CarbonSpark/CS_XCub_ThrottleQuad/Arduino Code/readme

This folder contains the code file I used for the Arduino Teensy 4.1 that is driving the prototype unit.
