CarbonSpark/CS_XCub_ThrottleQuad/Fuel Selector/readme

This folder contains all of the STL's for the Fuel Selector Switch.
