CarbonSpark/CS_XCub_ThrottleQuad/Levers/readme

This folder contains all of the STL's for the Throttle and Prop Levers.
