CarbonSpark/CS_XCub_ThrottleQuad/Flap Lever/readme

This folder contains all of the STL's for the Flap Lever Arm.
