CarbonSpark/CS_XCub_ThrottleQuad/Covers/readme

This folder contains all of the cover panel STL's for the Throttle.
