CarbonSpark/CS_XCub_ThrottleQuad/Frames/readme

This folder contains all of the STL files to build the main framework for the throttle unit.
