CarbonSpark/CS_XCub_ThrottleQuad/Documents/Hardware List.xlsx

Component Type | Fastener Qty | Description | Notes | McMaster Carr Part Number
Frames
 | 37 | M3 x 0.5mm Heat Set Insert, brass, short | Primary fasteners for M3 screw embeded into parts. Used for cover panels and non load bearing parts. Sourced from Amazon
 | 32 | M4 x 0.7mm Heat Set Insert, brass, short | Primary fasteners for M4 screw embeded into parts. Used for load bearing and frame to fram connections. Sourced from Amazon
 | 2 | M3 x 0.5mm x 12mm Socket Head Screws | Attaches the Top Frame Bracket to both Flap Lever Side brackets. | 91290A117
 | 32 | M4 x 0.7mm x 12mm Socket Head Screws | Main Screws used for assembling the frames together. | 91290A148
 | 6 | M4 x 0.7mm x 8mm Socket Head Screws | For attaching the bottom of Throttle Frames to Center Frame | 91292A108
 | 6 | M4 x 0.7mm x 20mm Socket Head Screws | For attaching the top of Throttle Frames to Top Frame. | 91290A168
 | 6 | M4 0.7mm Lock Nuts | For the 20mm M4 Screws used on the top of the Throttle frames.
Cover Panels
 | 6 | M3 x 0.5mm x 5mm Button Head Screws | For attaching the top cover to the top frame. | 94500A263
 | 32 | M3 x 0.5mm x 6mm Button Head Screws | For attaching all remaining cover panels to frames. | 94500A221
Flap Lever
 | 1 | 3mm x 40mm Dowel Pin | Trigger Stop Pin. Prevents the push rod assembly from pushing the trigger out of the handle. | 93890A702
 | 1 | 3mm x 16mm Headless Clevis Pin w/E-clips | Axle for trigger. | 91595A117
 | 1 | 6mm x 30mm Headless Clevis Pin w/E-clips | Axle for detent pawl and spacers. Shaved the head of this pin to clearance the bolts holding the Detent Bracket to the Flap Frame | 93890A713
 | 2 | 13mm OD, 8mm Long, M6 Aluminum Spacer | These are the spacers for the detent pawl. One on each side of the pawl. Filing/milling required as the pawl needs to move with no resistance. | 94669A172
 | 2 | 8mm OD, 13mm long, M4 Aluminum Spacer | These are the spacers for the Detent Plate to Detent Bracket. | 94669A051
 | 2 | M4 x 0.7mm x 25mm screws | These screws attach the Detent Plate to the Detent Bracket.
 | 2 | M4 x 0.7mm x Lock Nuts | For the Detent Plate screws.
 | 2 | M4 x 0.7mm Washers | For the Detent Plate screws.
 | 1 | M6 x 1mm x 110mm Socket Head Screw | Attaches Flap Lever Arm through Flap Lever Axle and both Flap Side Frames. Can also use to adjust tension on the Flap Lever Arm | 91292A420
 | 1 | M6 x 1mm Lock Nut | For M6 110mm screw | 94205A153
 | 1 | M6 screw size Nylon Washer, Lubricant Filled | Located between Flap Lever Axle and Flap Support Frame 2, Lubricant Filled for smooth rolling action on the assembly. | 91545A450
 | 1 | 6201 Ball Bearing | Bearing used flap system to provide smooth rolling action. | 5972K313
 | 1 | 5mm OD aluminum rod | This is the push. Approx. 90mm long with the gentle bend. Must be custom fit to the assembly. Sourced from Amazon
 | 1 | 17mm Compression Spring | Push rod return spring. I used a 2.8 pound spring. Must be 17mm uncompressed. | 94125K523
 | 2 | M5 Oversized Washer | Retain 17mm spring to prevent binding, One on each end of the spring. | 91100A140
 | 1 | 5mm OD Push on Retaining Ring | For keeping the Washers and spring in place on the Trigger end of the Push rod | 92133A106
 | 2 | M4 x 0.7mm x 8mm Socket Head Screws | For mounting Detent Bracket to Flap Support Frame 1 | 91292A108
 | 1 | M4 x 0.7mm Nut (any type) | Epoxy this to the top of the Detent Pawl above the foot that push rod hits. This is used as a counter weight.
Flap Lever Switches
 | 2 | M3 x 0.5mm x 70mm Socket Head Screws | Attached the Flap Lever Switches through both Flap Support Frames and Flap Switch Cradle. | 91290A297
 | 2 | M3 x 0.5mm Lock Nuts | For the 70mm screws above.
Fuel Selector
 | 4 | M4 x 0.7mm x 20mm Socet Head Screw | Attaches the Cutoff Guard Mount Ring to Switch Cup | 91290A168
 | 4 | M4 Lock Nuts | For Cutoff Guard Mount Ring Screws
 | 2 | Precision M5 Shoulder Bolts, Ultra Low Profile | Ultra-Low-Profile Precision Shoulder Screw, 5 mm Shoulder Diameter, 10 mm Shoulder Length, M4 x 0.70 mm Thread. For Cutoff Guard | 90318A810
 | 2 | 11.5mm Long Compression Springs | For Cutoff Guard. Mounts under the guard, with the shoulder bolt through the spring. 2.8 pound springs. | 94125K521
 | 2 | M4 Heat Set Insert, brass, short | For mountin the shoulder bolts to the ring. Sourced from Amazon.
T&P Levers
 | 2 | Knurled M5 Knobs | These knobs are the axles for the Throttle and Prop Levers. Also used for tensioning the Levers. M5 x 0.8mm x 25mm long stud. | 61165K71
 | 5 | M5 Nylon Washers, Lubricant filled. | Use 1 between each Front Lever Plate (magnet side) and the Left/Right Throttle Frames. Remaining are used as spacers on the Knob, inside housing. | 91545A440
 | 2 | M5 x 0.8mm Nuts, Non Locking | Used on the Rear Lever Plate, Holds each assembly together. Loctite optional.
 | 8 | M2 x 0.4mm x8mm screws, Phillips Head | Use in conjuction with nuts and lock washer to asseble lever plates. Sourced from Amazon as part of a screw kit.
 | 8 | M2 x 0.4mm x8mm nuts | For 8mm screws
 | 8 | M2 x 0.4mm x8mm lock washers | For 8mm screws
 | 1 | 3/4" x 1/16" Aluminum Flat Bar | Sourced from local home improvement store. These are the Prop/Throttle Levers. Bend to desired shape. Drill 5.2mm hole in center for the Knobs
 | 2 | M3 x 0.5mm x 6mm Button Head Screws | For attaching the Prop and Throttle Knobs.
 | 4 | 1/8" x 1/4" Foam Weather Strip, cut to length | Used on the Top frame slots for the Throttle and Prop Levers. Adds resistance to the levers, keeps dust out of the slots. Sourced from Amazon
 | 2 | 1/8" x 1/8" x 1/2" Neodymium Magnets | These magnets are for the hall effect sensors. Poles are oriented at the small ends of the magnet, not the long face. | www.KJmagnetics.com
Electronics
 | 2 | Honeywell SS496A1 Hall Effect Sensors | Hall effect Sensors for the Throttle and Prop Sensors. Epoxied in the small notch on the inside of Left/Right Throttle Frames. | AlliedElectronics.com
 | 1 | C&K Rotart Switch A12405RNZB | Fuel Selector Switch. 4 position, 90 degree indexing. | Mouser.com
 | 4 | E-Switch LS0851505F250C1A Limit Switches | Flap position switch. Roller faced, lever action limit switch. | Mouser.com
 | 3 | C&K DF62J12S215QA Rocker Switch | Basic SPDT Rocker Switch. Closest resemblance to the switches in the actual Xcub. Water Rudder, Gear, Parking Brake switches | Mouser.com
 | 1 | Arduino Teensy 4.1 | The brain of the unit. Sourced from Amazon but available at other locations. You can use any controller you want, I just used this one.
 |  | 24 Gauge Wire (any color) | I used stranded for everything but the common ground which is solid wire.
 |  | Heatshrink Tubing (various sizes)
 |  | Dupont style Male/Female Pins and Connectors | For terminating wires and hooking up to the Arduino
Desk Mount
 | 1 | J-Pein Universal Joystick Mount | Sourced from Amazon, this is an inexpensive mount for a joystick. Modified by cutting the main bar to length for the throttle.
 |  |  | Additional Comments
 |  |  | The hardware list above contains everything I have used to build the prototype unit. The list is rather extensive. There is a chance that I may have missed
 |  |  | something. If that is the case, DM me on the BLL discord (CarbonSpark) and I will add it to the list.
 |  |  | I used McMaster Carr as a harware provider. They are a US based company and if they don’t have it, it doesn't exist. If the part number from McMaster isn't
 |  |  | listed next to the line item, it is because I used a generic fastener I had on hand (like the M4/M3 lock nuts). You can use a substitute.
