CarbonSpark/CS_XCub_ThrottleQuad/Covers/Back Cover.stl

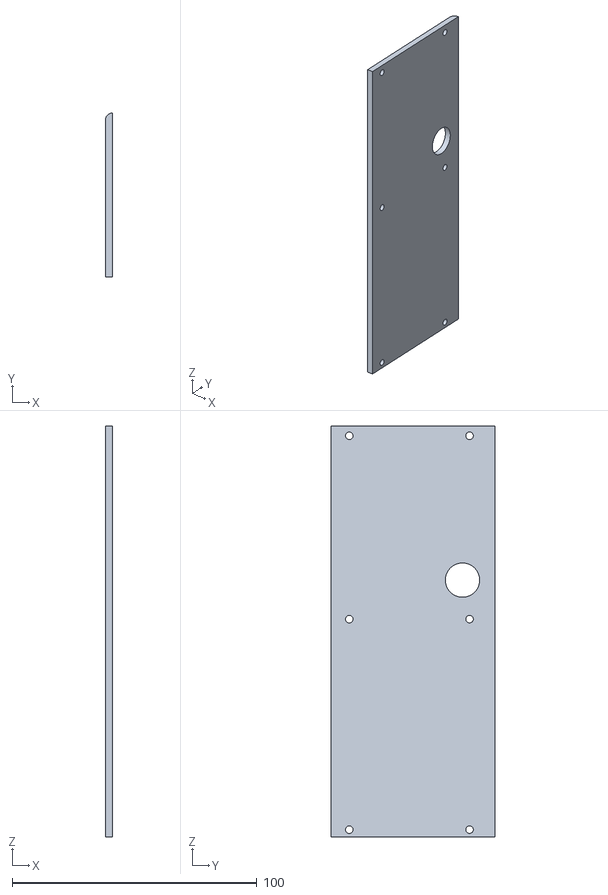
[picture p1: CAD file, 2021-11-14]
Covers/Back Cover.stl
3.00 x 67.1 x 168.0
