CarbonSpark/CS_XCub_ThrottleQuad/Flap Lever/Upper Push Rod Guide.stl

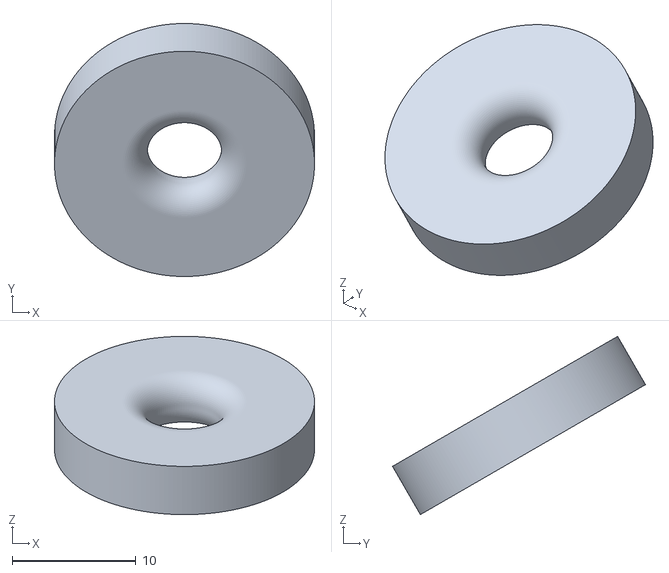
[picture p2: CAD file, 2021-11-14]
Flap Lever/Upper Push Rod Guide.stl
21.0 x 20.4 x 14.4
