CarbonSpark/CS_XCub_ThrottleQuad/Frames/Top Frame.stl

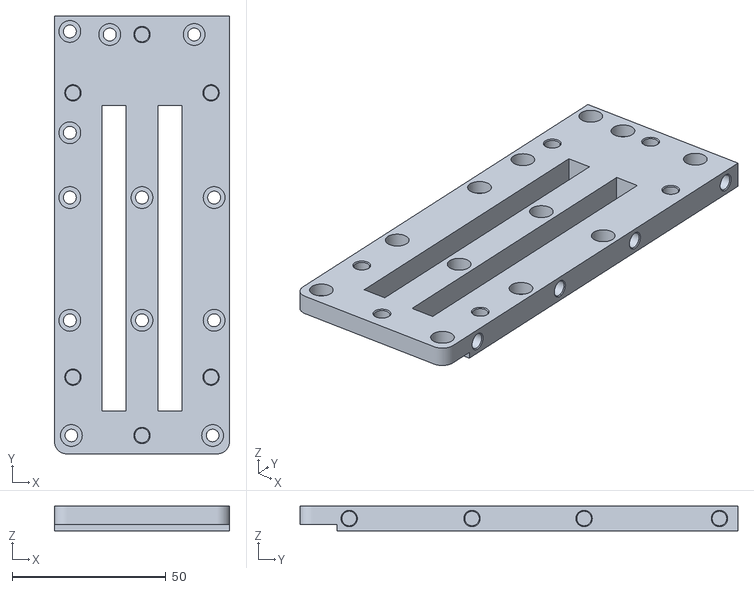
[picture p3: CAD file, 2021-11-14]
Frames/Top Frame.stl
57.0 x 142.6 x 8.00
