CarbonSpark/CS_XCub_ThrottleQuad/Fuel Selector/Fuel Selector Cup_V2.stl

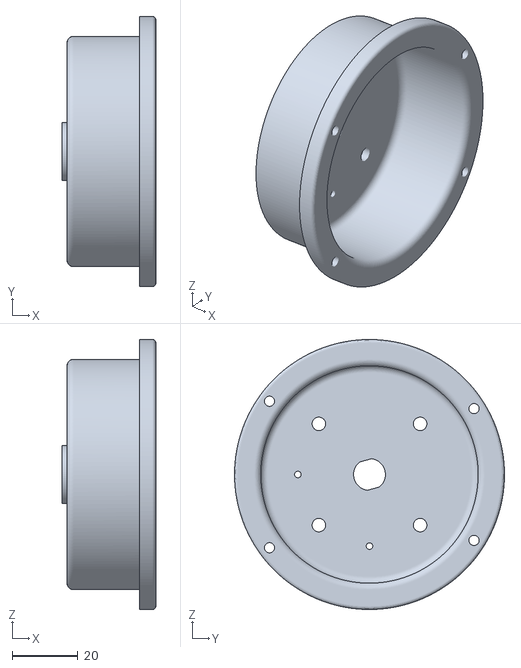
[picture p4: CAD file, 2021-11-14]
Fuel Selector/Fuel Selector Cup_V2.stl
28.5 x 82.0 x 82.0
