CarbonSpark/CS_XCub_ThrottleQuad/Levers/Lever Plate Front.stl

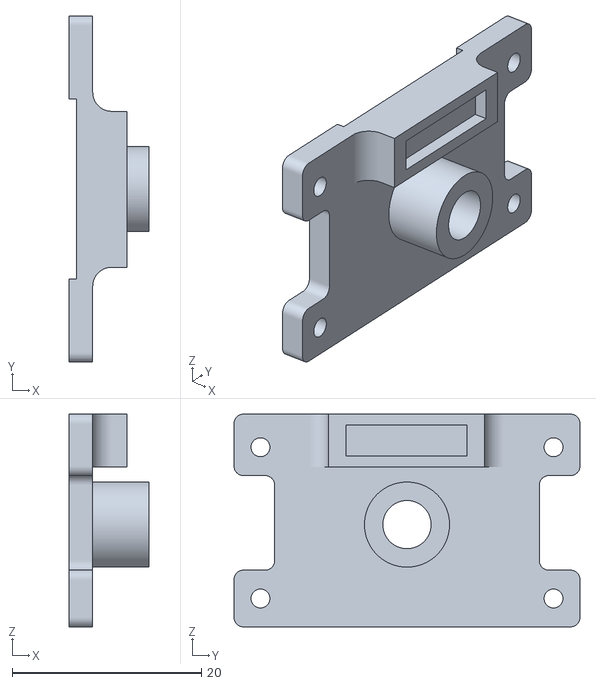
[picture p5: CAD file, 2021-11-14]
Levers/Lever Plate Front.stl
8.44 x 36.6 x 22.5
