CarbonSpark/CS_XCub_ThrottleQuad/Covers/Upper Front Cover.stl

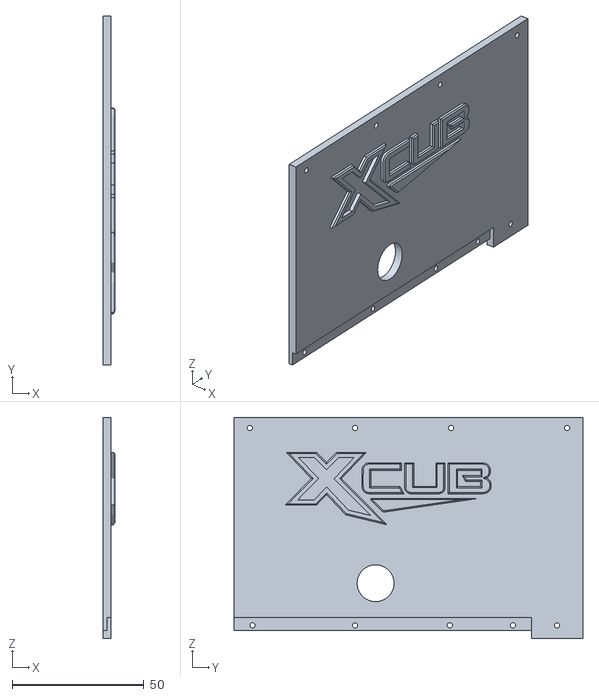
[picture p6: CAD file, 2021-11-14]
Covers/Upper Front Cover.stl
4.50 x 132.6 x 84.0
