CarbonSpark/CS_XCub_ThrottleQuad/Flap Lever/Flap Detent.stl

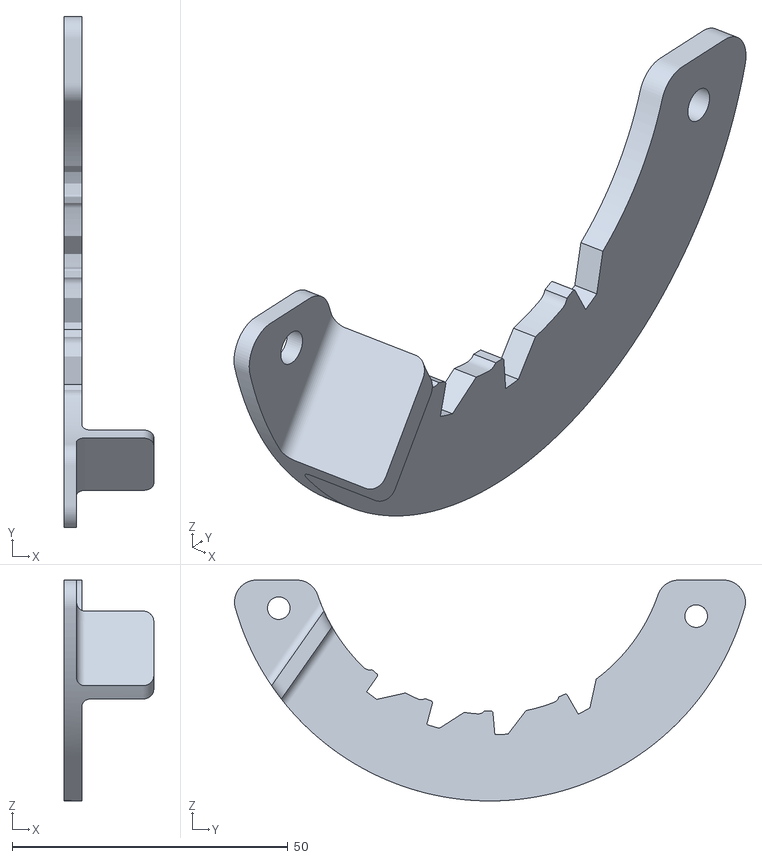
[picture p7: CAD file, 2021-11-14]
Flap Lever/Flap Detent.stl
16.3 x 92.7 x 40.1
