CarbonSpark/CS_XCub_ThrottleQuad/Frames/Arduino Bracket.stl

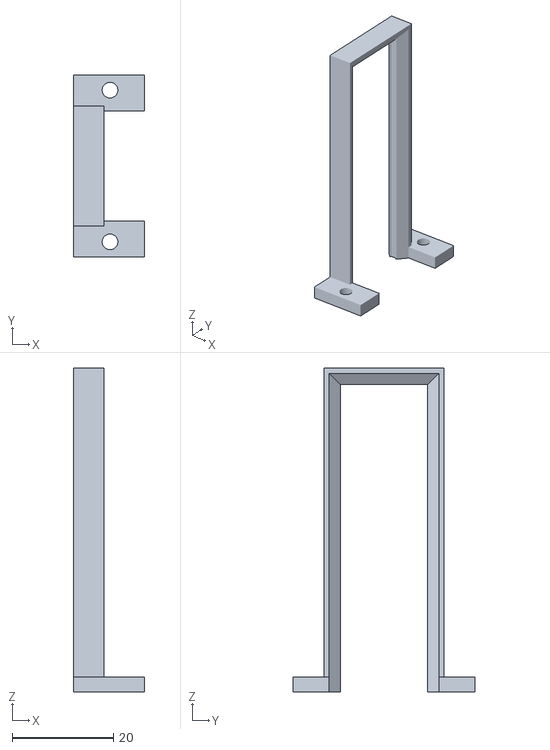
[picture p8: CAD file, 2021-11-14]
Frames/Arduino Bracket.stl
14.0 x 36.0 x 64.0
