CarbonSpark/CS_XCub_ThrottleQuad/Fuel Selector/Guard Mount Ring.stl

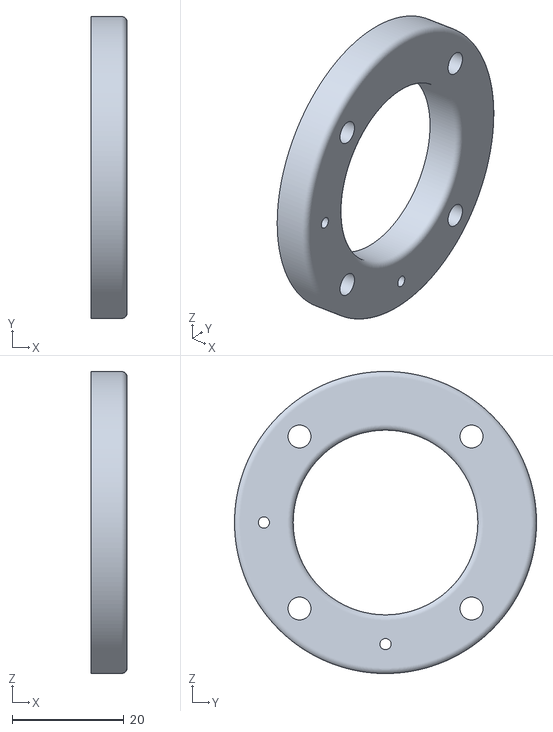
[picture p9: CAD file, 2021-11-14]
Fuel Selector/Guard Mount Ring.stl
6.50 x 54.0 x 54.0
