CarbonSpark/CS_XCub_ThrottleQuad/Levers/Throttle Knob.stl

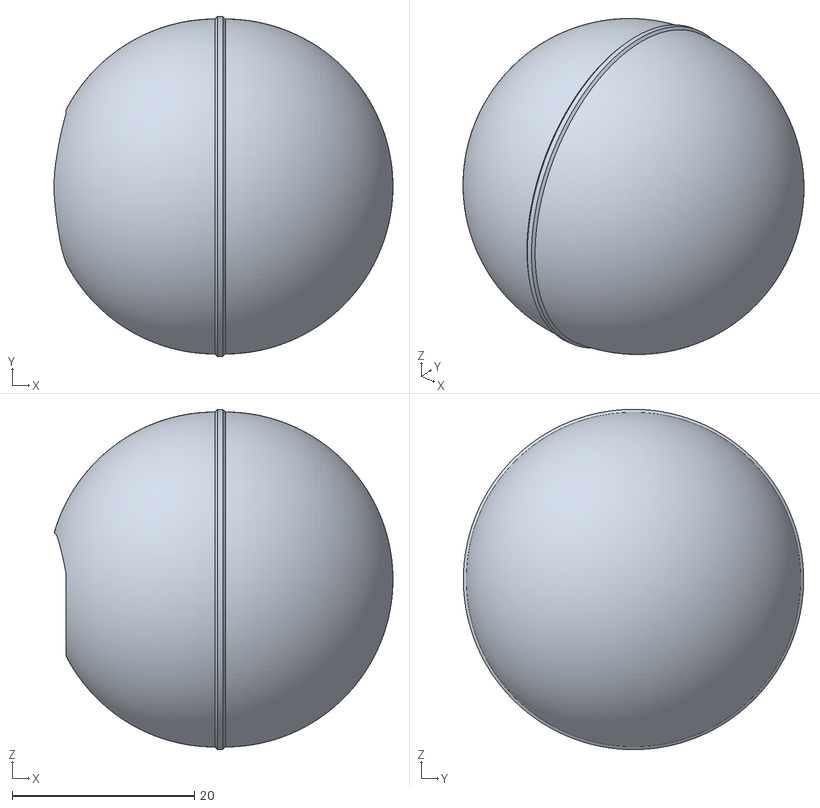
[picture p10: CAD file, 2021-11-14]
Levers/Throttle Knob.stl
37.2 x 37.4 x 37.4
