CarbonSpark/CS_XCub_ThrottleQuad/Covers/Short Side Cover.stl

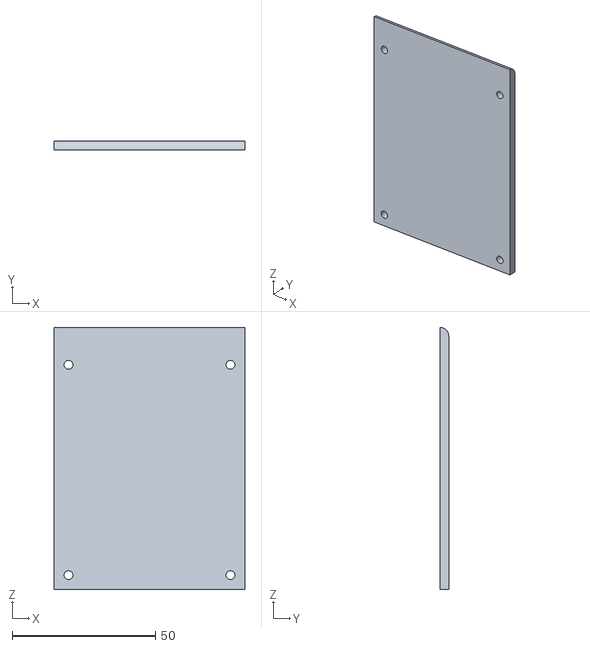
[picture p11: CAD file, 2021-11-14]
Covers/Short Side Cover.stl
66.5 x 3.00 x 91.4
