CarbonSpark/CS_XCub_ThrottleQuad/Flap Lever/Flap Bearing Cover.stl

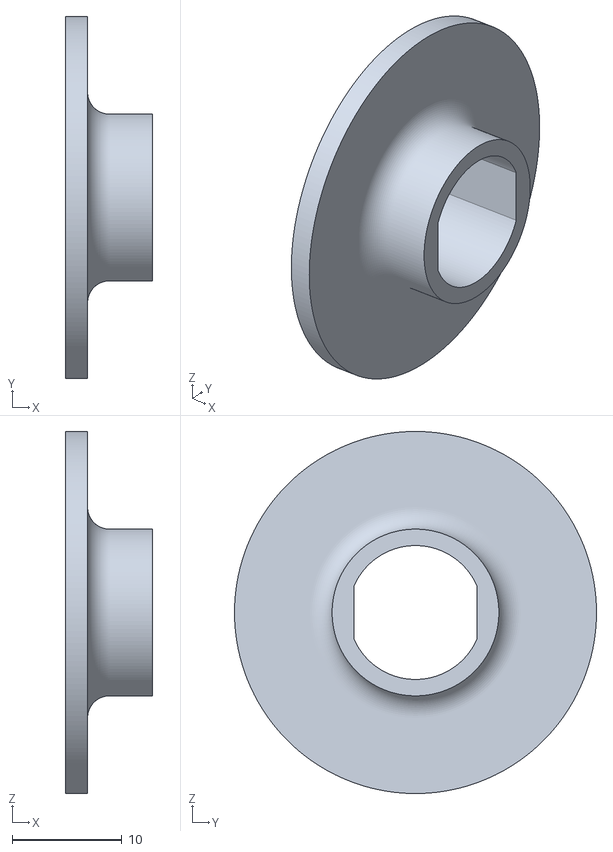
[picture p12: CAD file, 2021-11-14]
Flap Lever/Flap Bearing Cover.stl
7.90 x 33.0 x 33.0
