CarbonSpark/CS_XCub_ThrottleQuad/Frames/Center Support Throttle.stl

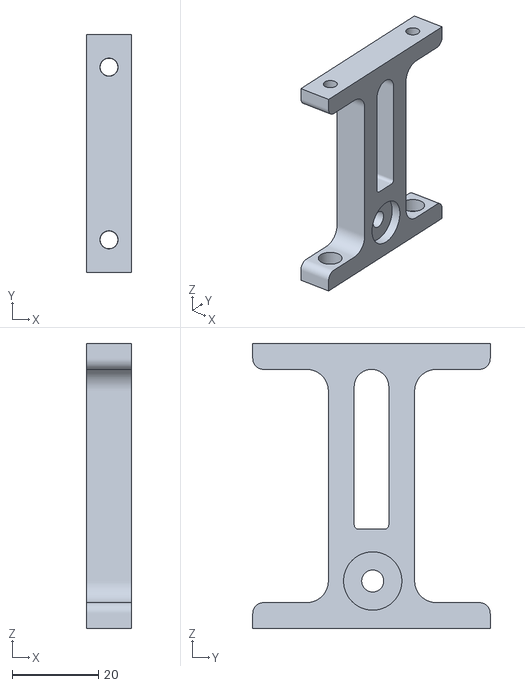
[picture p13: CAD file, 2021-11-14]
Frames/Center Support Throttle.stl
10.5 x 55.0 x 66.0
