CarbonSpark/CS_XCub_ThrottleQuad/Fuel Selector/Fuel KnobV2.stl

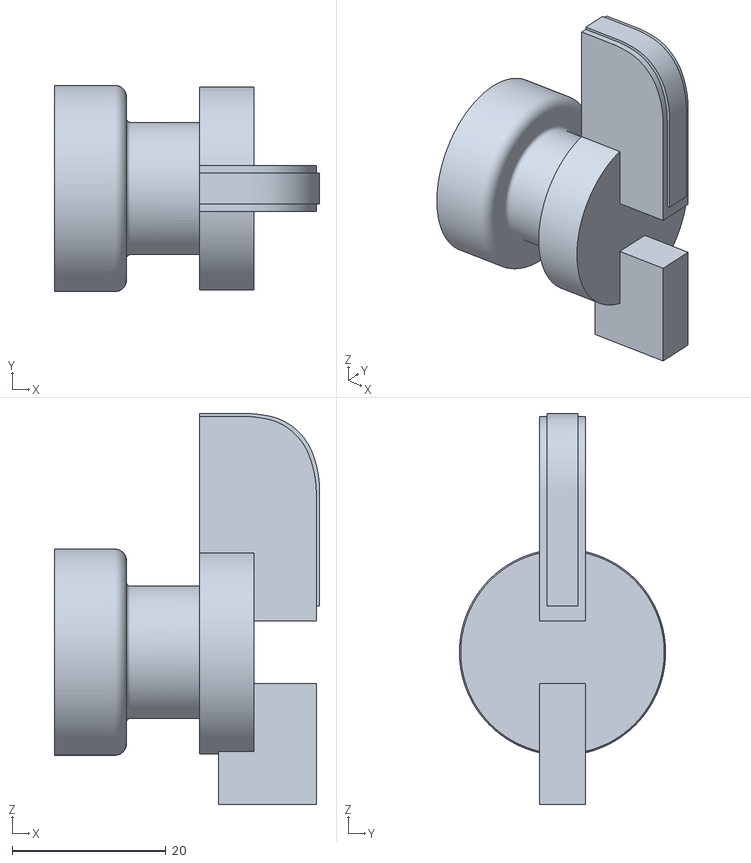
[picture p14: CAD file, 2021-11-14]
Fuel Selector/Fuel KnobV2.stl
34.5 x 26.8 x 50.9
