CarbonSpark/CS_XCub_ThrottleQuad/Levers/Lever Plate Back.stl

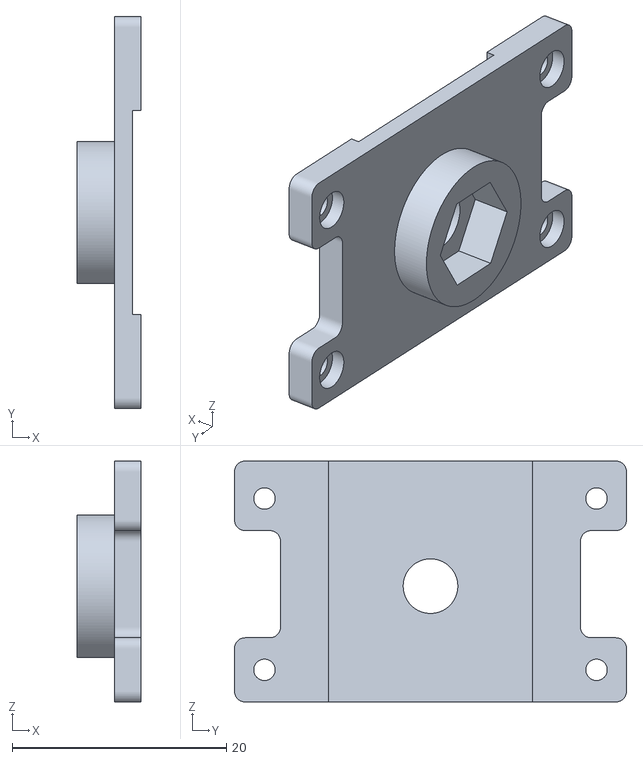
[picture p15: CAD file, 2021-11-14]
Levers/Lever Plate Back.stl
6.00 x 36.6 x 22.5
