CarbonSpark/CS_XCub_ThrottleQuad/Covers/Top Cover.stl

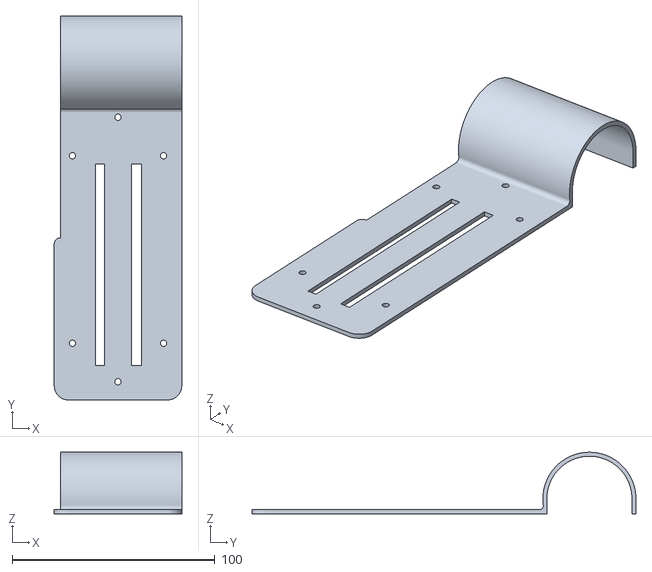
[picture p16: CAD file, 2021-11-14]
Covers/Top Cover.stl
63.0 x 189.6 x 30.4
