CarbonSpark/CS_XCub_ThrottleQuad/Flap Lever/Spring Plate.stl

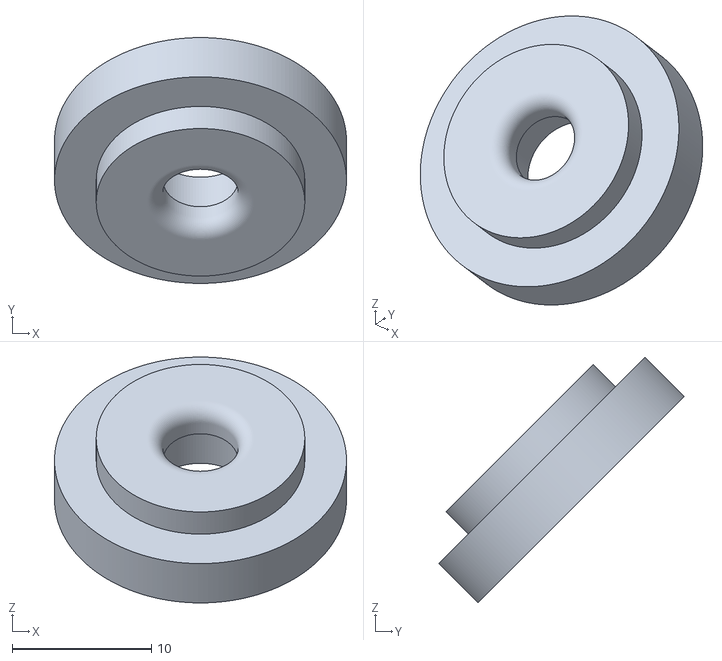
[picture p17: CAD file, 2021-11-14]
Flap Lever/Spring Plate.stl
21.0 x 17.7 x 17.7
