CarbonSpark/CS_XCub_ThrottleQuad/Frames/Flap Support Frame 1.stl

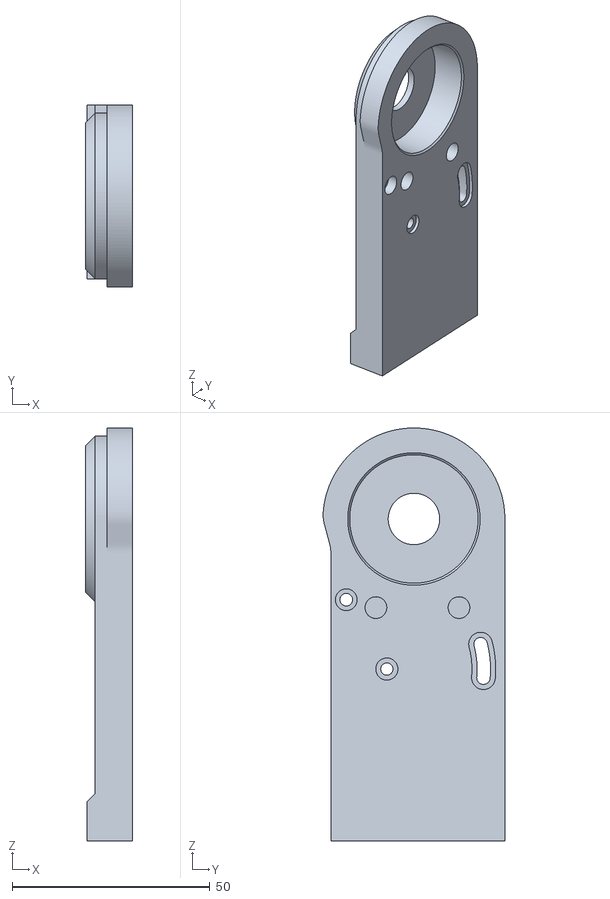
[picture p18: CAD file, 2021-11-14]
Frames/Flap Support Frame 1.stl
12.0 x 46.0 x 104.4
