CarbonSpark/CS_XCub_ThrottleQuad/Fuel Selector/Cutoff Guard.stl

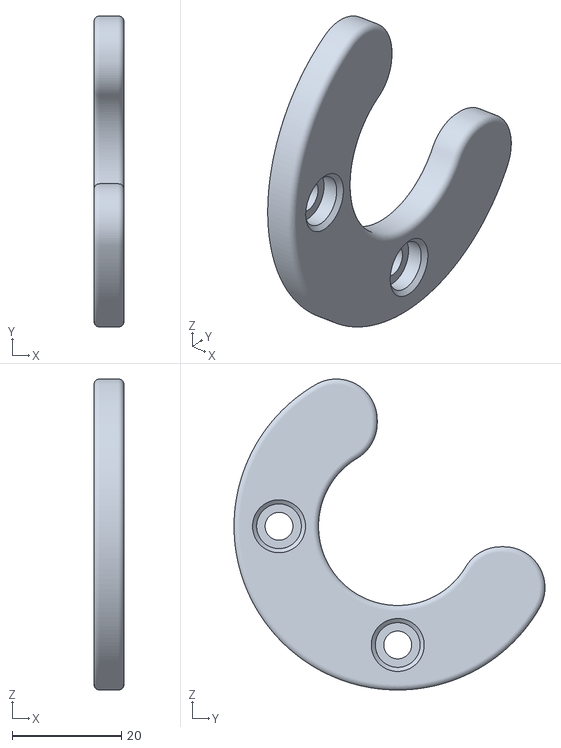
[picture p19: CAD file, 2021-11-14]
Fuel Selector/Cutoff Guard.stl
5.50 x 57.0 x 57.0
