CarbonSpark/CS_XCub_ThrottleQuad/Levers/Prop Knob.stl

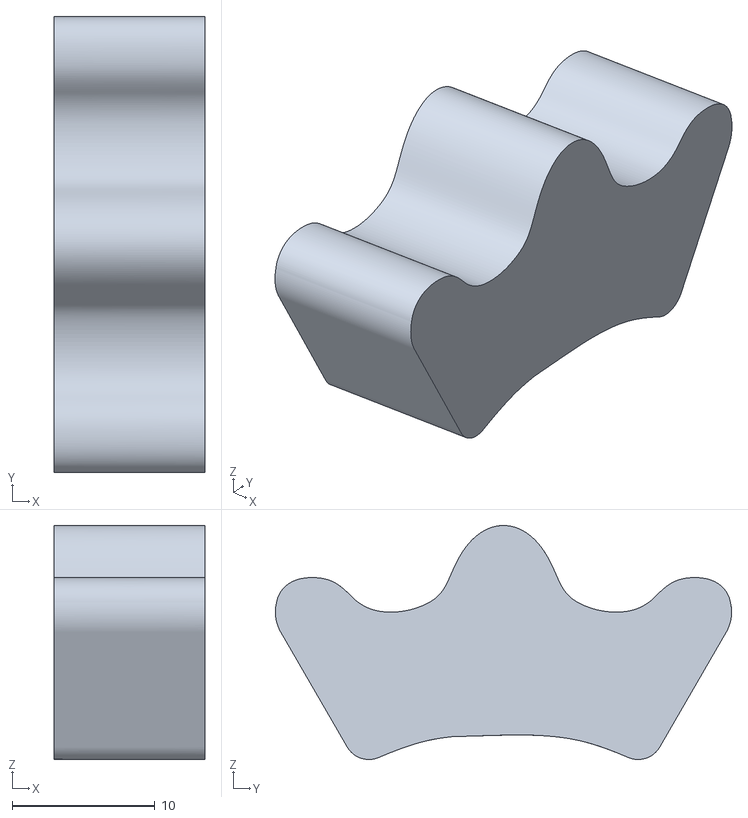
[picture p20: CAD file, 2021-11-14]
Levers/Prop Knob.stl
10.6 x 32.0 x 16.4
