CarbonSpark/CS_XCub_ThrottleQuad/Covers/Lower Front Cover.stl

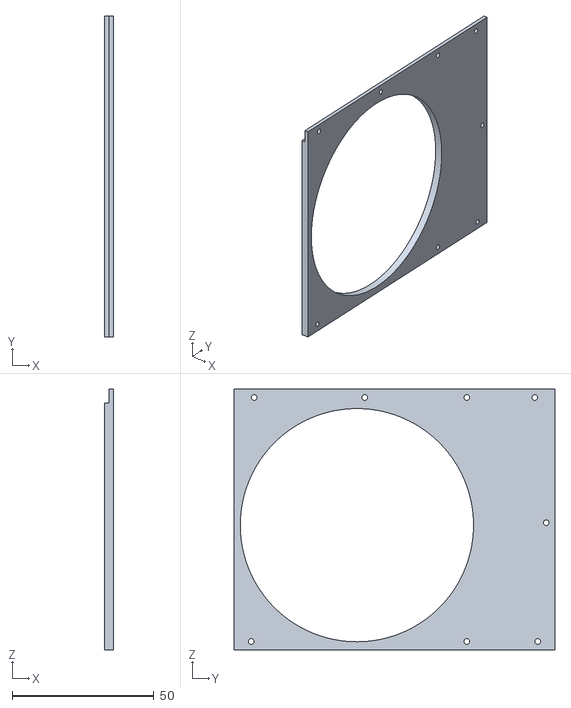
[picture p21: CAD file, 2021-11-14]
Covers/Lower Front Cover.stl
3.00 x 113.0 x 92.0
