CarbonSpark/CS_XCub_ThrottleQuad/Flap Lever/Flap trigger.stl

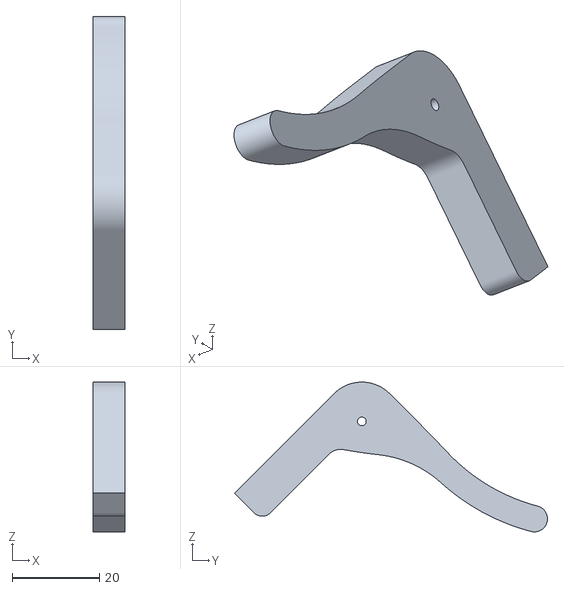
[picture p22: CAD file, 2021-11-14]
Flap Lever/Flap trigger.stl
7.25 x 71.7 x 34.3
