CarbonSpark/CS_XCub_ThrottleQuad/Frames/Upper Side Frame.stl

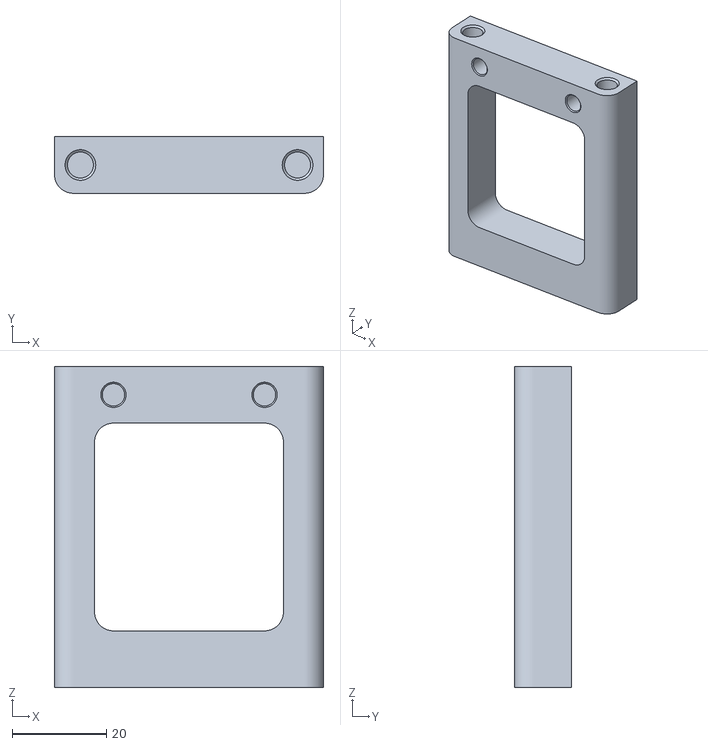
[picture p23: CAD file, 2021-11-14]
Frames/Upper Side Frame.stl
57.0 x 12.0 x 68.0
