CarbonSpark/CS_XCub_ThrottleQuad/Covers/Long Side Cover.stl

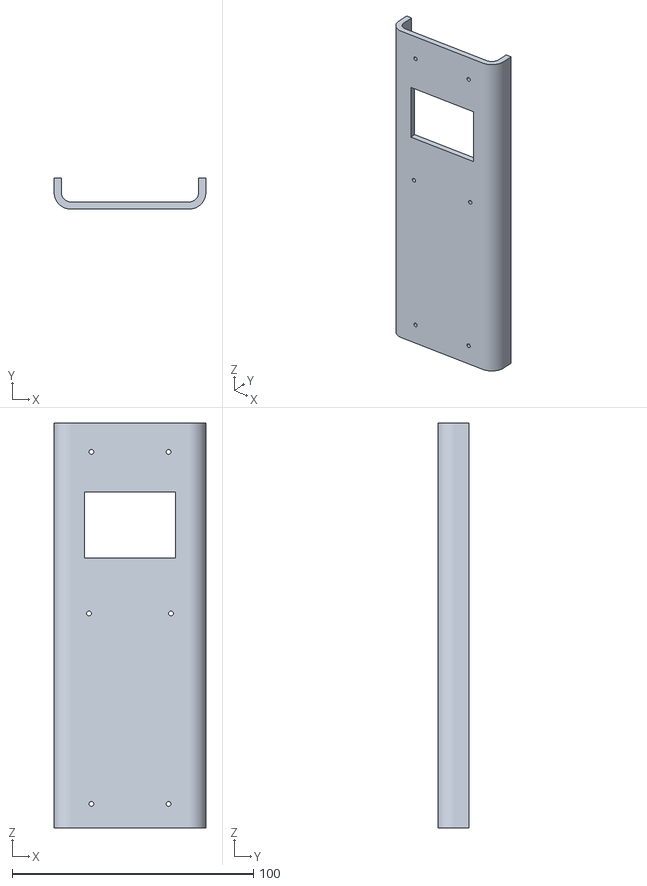
[picture p24: CAD file, 2021-11-14]
Covers/Long Side Cover.stl
63.0 x 13.0 x 168.0
