CarbonSpark/CS_XCub_ThrottleQuad/Flap Lever/Detent Mount Bracket.stl

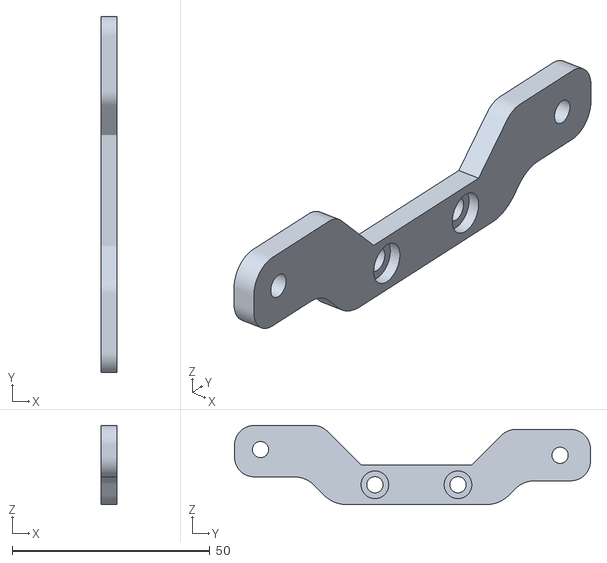
[picture p25: CAD file, 2021-11-14]
Flap Lever/Detent Mount Bracket.stl
4.12 x 90.0 x 20.0
