CarbonSpark/CS_XCub_ThrottleQuad/Frames/Left Throttle Supp Bracket.stl

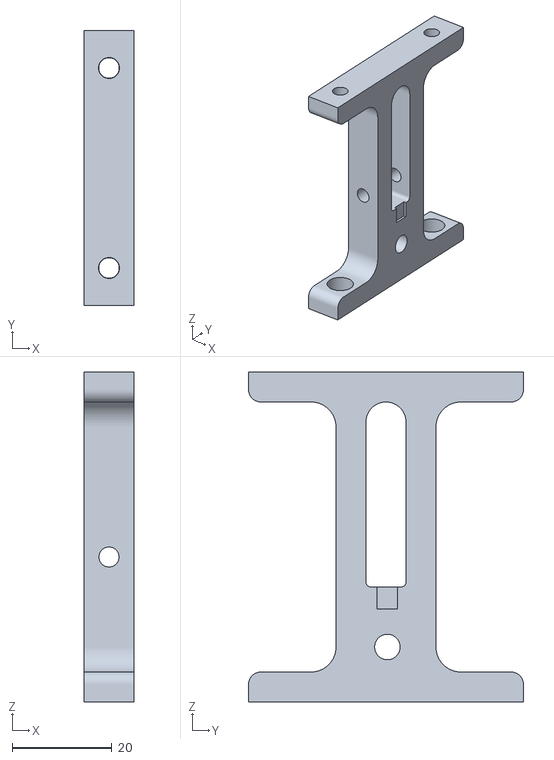
[picture p26: CAD file, 2021-11-14]
Frames/Left Throttle Supp Bracket.stl
10.0 x 55.0 x 66.0
