CarbonSpark/CS_XCub_ThrottleQuad/Flap Lever/Flap Lever Arm.stl

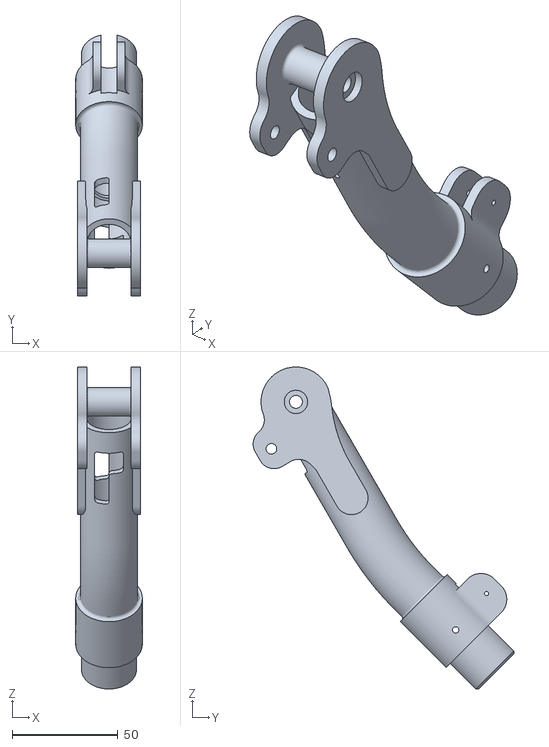
[picture p27: CAD file, 2021-11-14]
Flap Lever/Flap Lever Arm.stl
31.5 x 123.2 x 152.2
