CarbonSpark/CS_XCub_ThrottleQuad/Frames/Flap Support Frame 2.stl

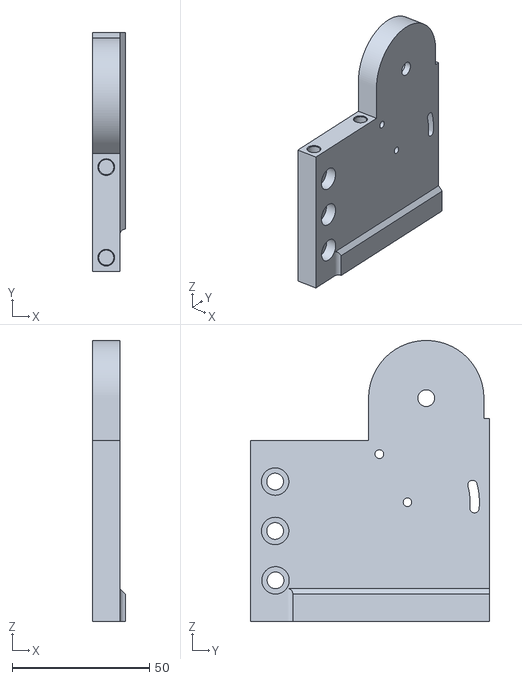
[picture p28: CAD file, 2021-11-14]
Frames/Flap Support Frame 2.stl
12.0 x 87.0 x 102.4
