CarbonSpark/CS_XCub_ThrottleQuad/Flap Lever/Flap Lever Axle_V2.stl

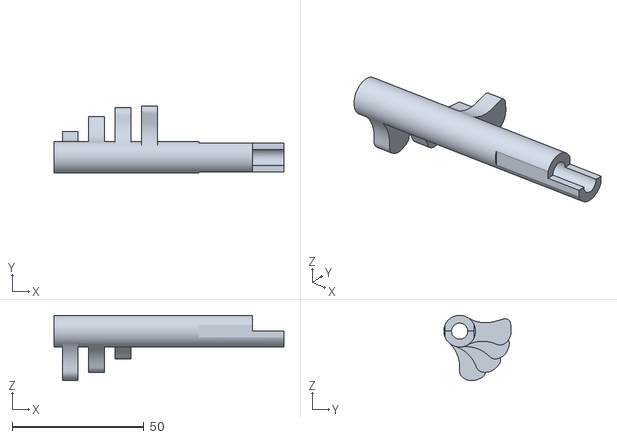
[picture p29: CAD file, 2021-11-14]
Flap Lever/Flap Lever Axle_V2.stl
87.2 x 25.5 x 24.8
