CarbonSpark/CS_XCub_ThrottleQuad/Frames/Bottom Side Frame.stl

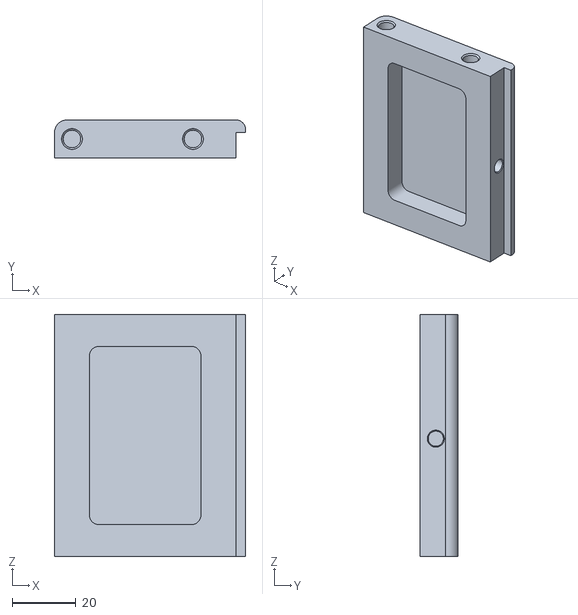
[picture p30: CAD file, 2021-11-14]
Frames/Bottom Side Frame.stl
60.0 x 12.0 x 76.0
