CarbonSpark/CS_XCub_ThrottleQuad/Flap Lever/Flap Switch Cradle.stl

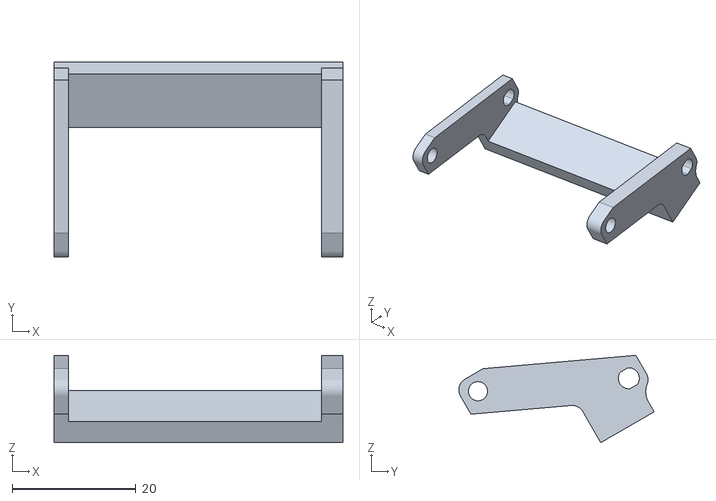
[picture p31: CAD file, 2021-11-14]
Flap Lever/Flap Switch Cradle.stl
46.8 x 31.6 x 14.1
