CarbonSpark/CS_XCub_ThrottleQuad/Frames/Bottom Frame.stl

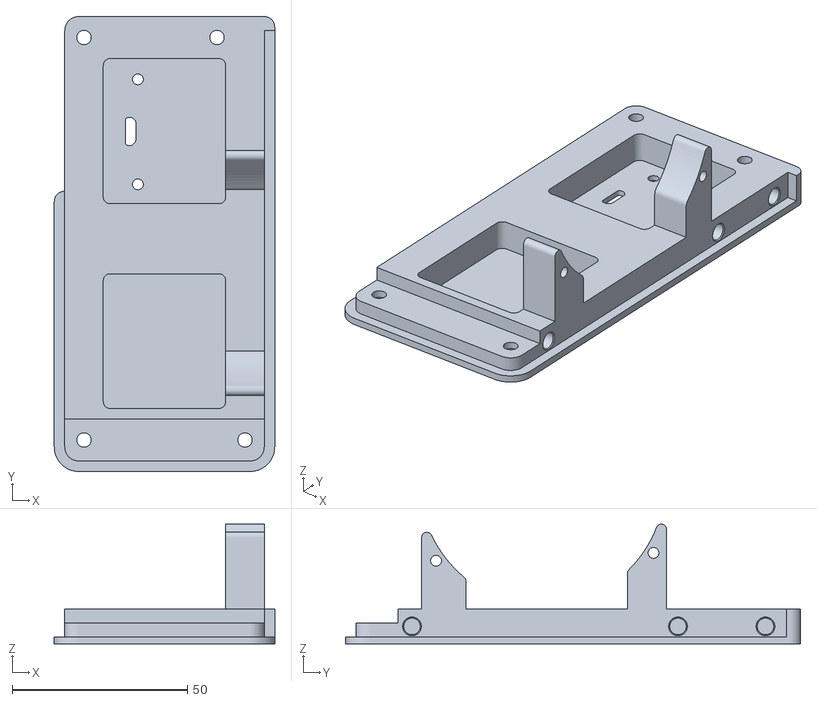
[picture p32: CAD file, 2021-11-14]
Frames/Bottom Frame.stl
63.0 x 130.0 x 34.2
