CarbonSpark/CS_XCub_ThrottleQuad/Flap Lever/Detent Pawl.stl

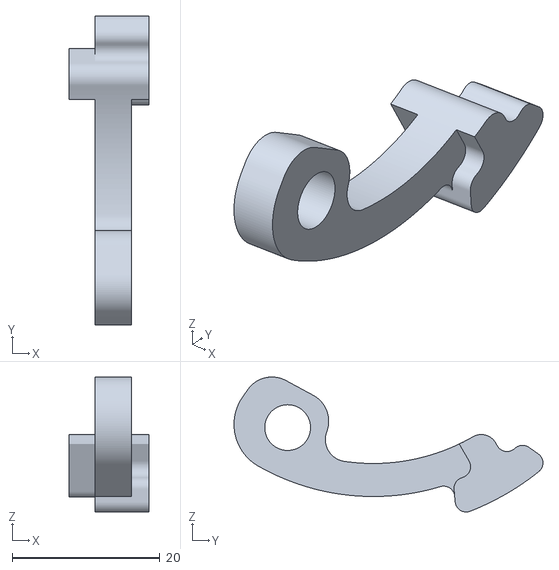
[picture p33: CAD file, 2021-11-14]
Flap Lever/Detent Pawl.stl
10.9 x 41.9 x 18.3
