CarbonSpark/CS_XCub_ThrottleQuad/Frames/Center Frame.stl

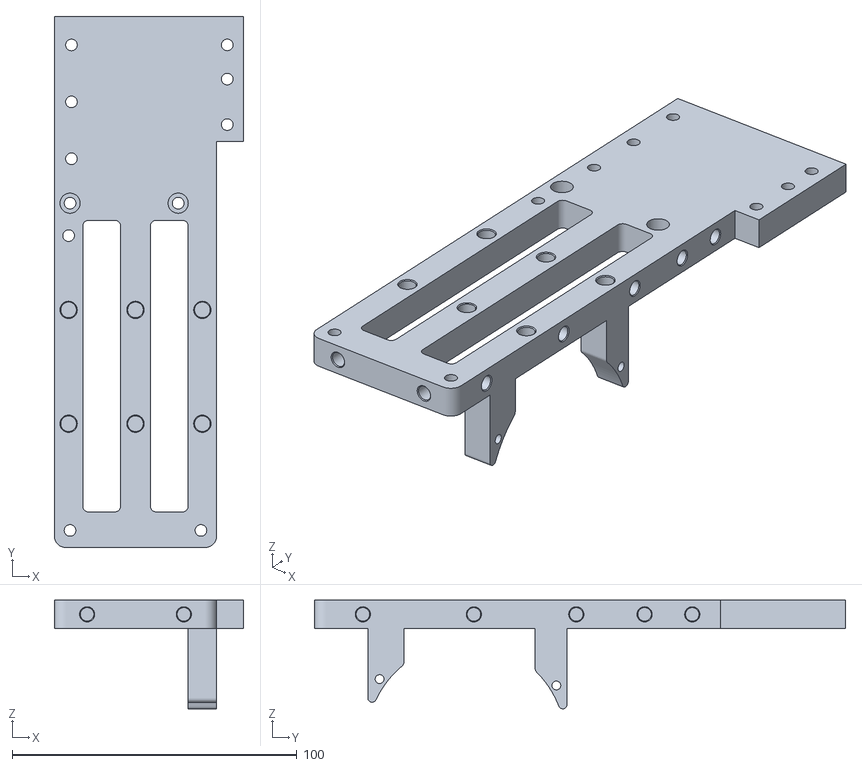
[picture p34: CAD file, 2021-11-14]
Frames/Center Frame.stl
66.5 x 186.6 x 38.2
