CarbonSpark/CS_XCub_ThrottleQuad/Flap Lever/Flap Handle Extention.stl

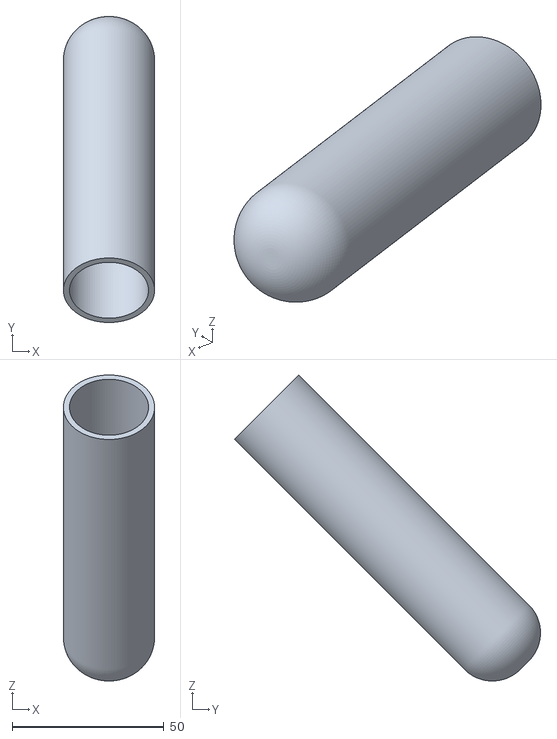
[picture p35: CAD file, 2021-11-14]
Flap Lever/Flap Handle Extention.stl
30.0 x 100.7 x 100.7
