CarbonSpark/CS_XCub_ThrottleQuad/Frames/Lower Side Frame.stl

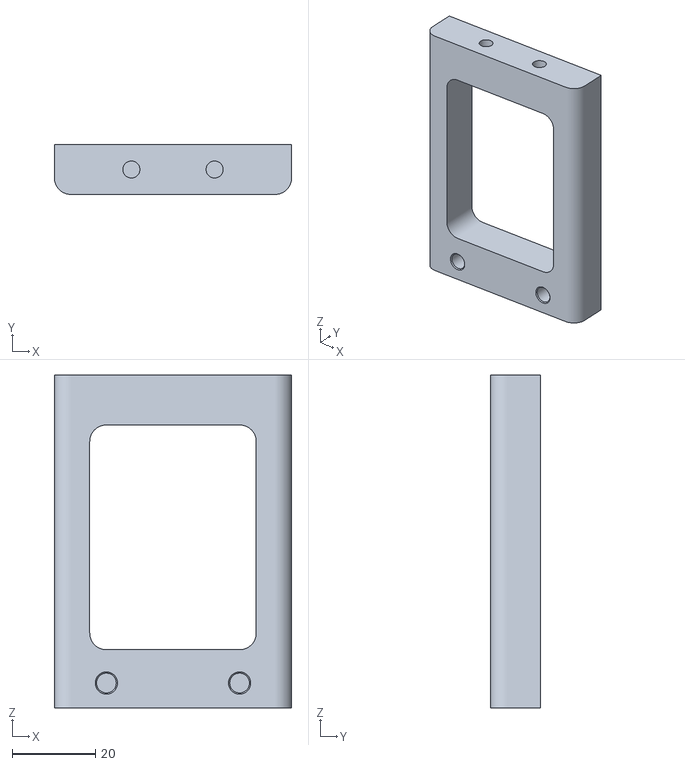
[picture p36: CAD file, 2021-11-14]
Frames/Lower Side Frame.stl
57.0 x 12.0 x 80.0
