CarbonSpark/CS_XCub_ThrottleQuad/Frames/Top to Flap Bracket.stl

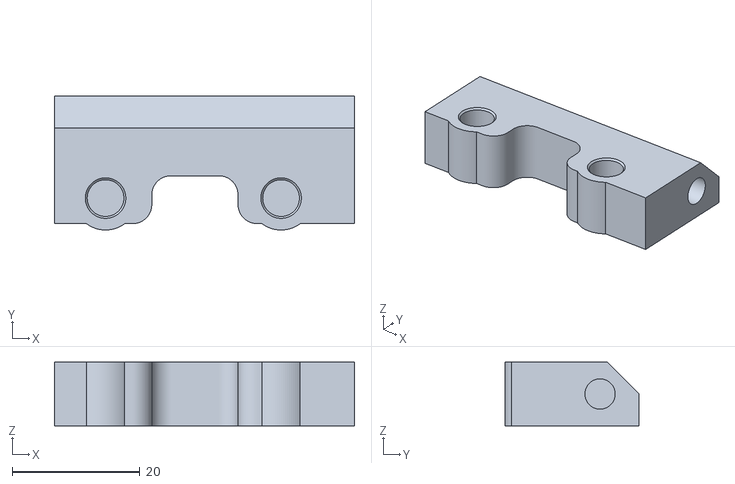
[picture p37: CAD file, 2021-11-14]
Frames/Top to Flap Bracket.stl
47.0 x 21.0 x 10.0
