CarbonSpark/CS_XCub_ThrottleQuad/(list of files, cad)

Other CAD files:
Frames/Right Support Throttle.stl
